Deadeye5589/RedButton/V2/Schematic/Schematic.pdf

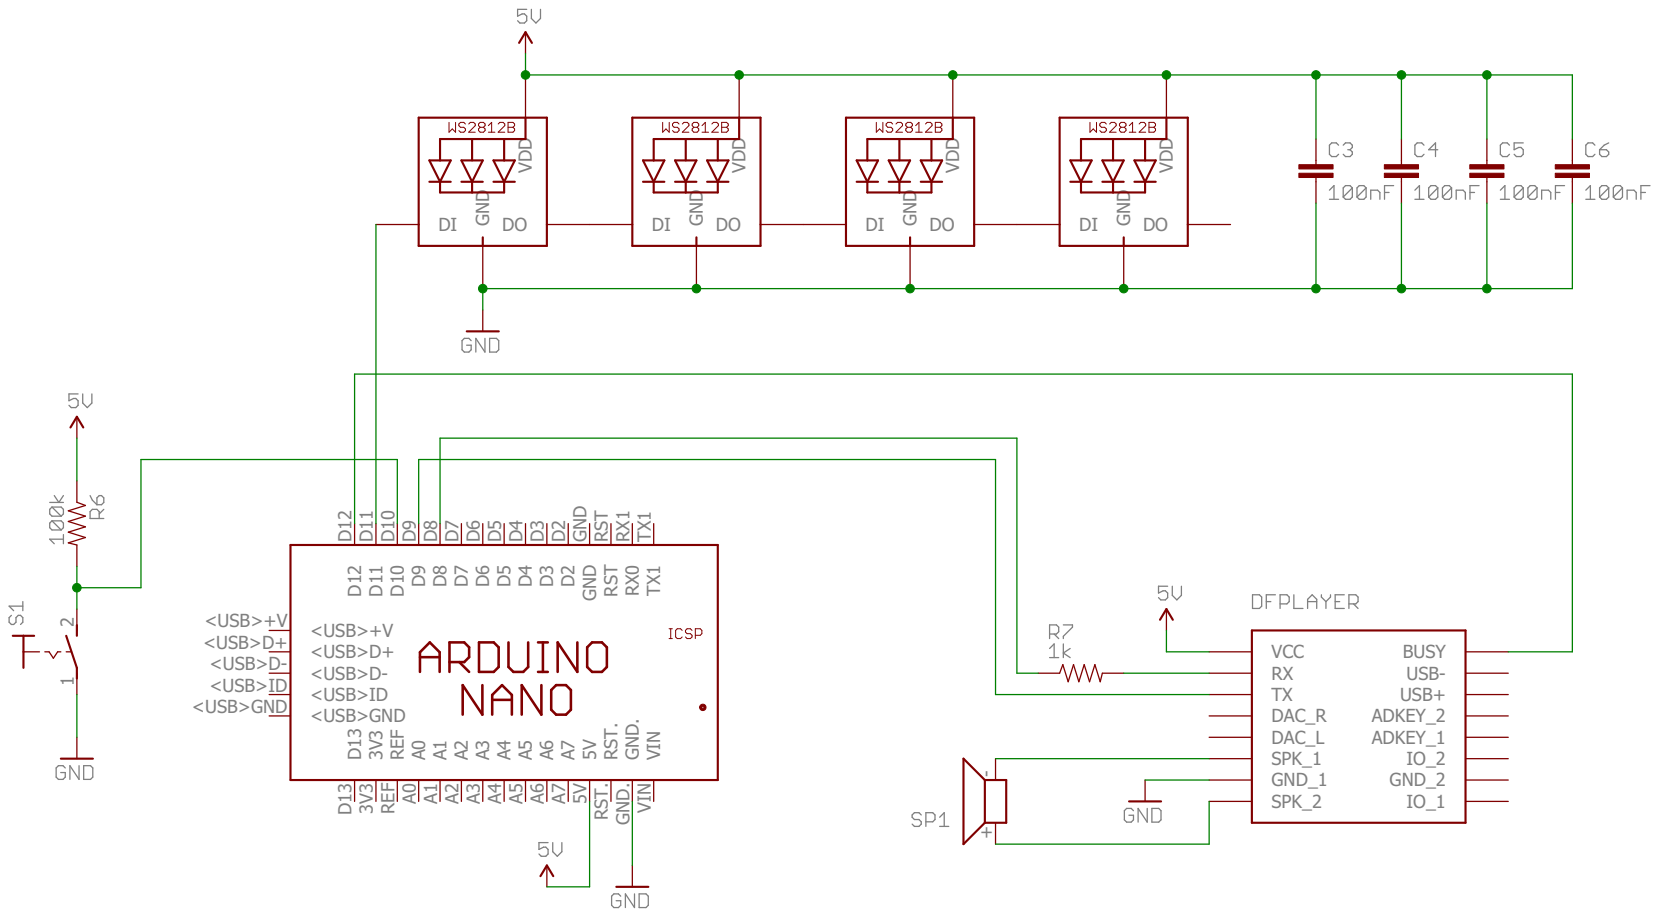
[picture p1: page 1]

<USB>ID
<USB>GND
