Deadeye5589/RedButton/V1/Schematic/Schematic.pdf

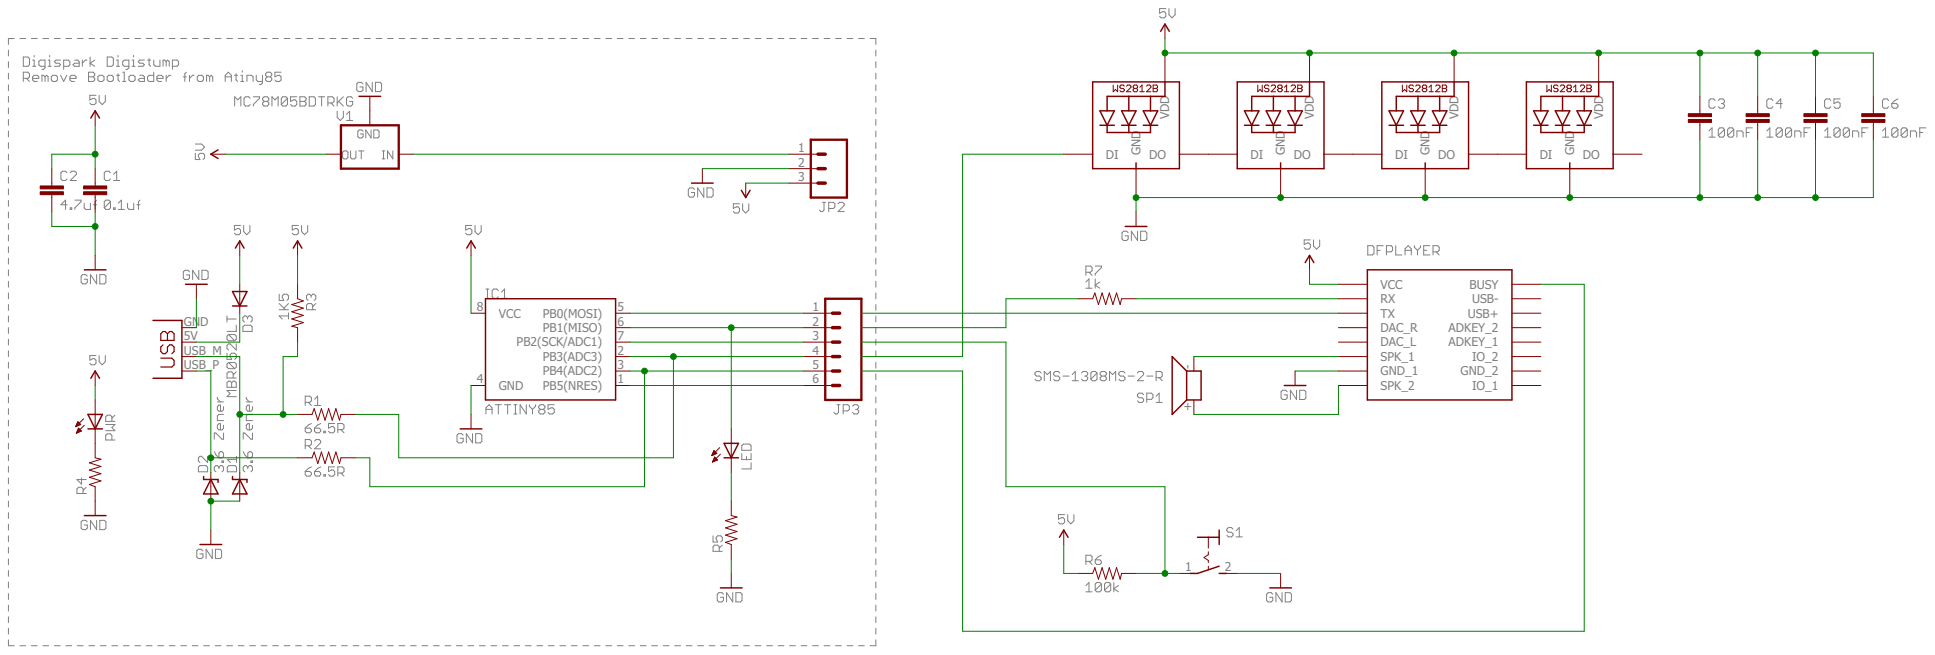
[picture p2: page 1]
