Deadeye5589/RedButton/V2/Schematic/Schematic.sch

## EAGLE design V2/Schematic/Schematic.sch (2019-01-21)

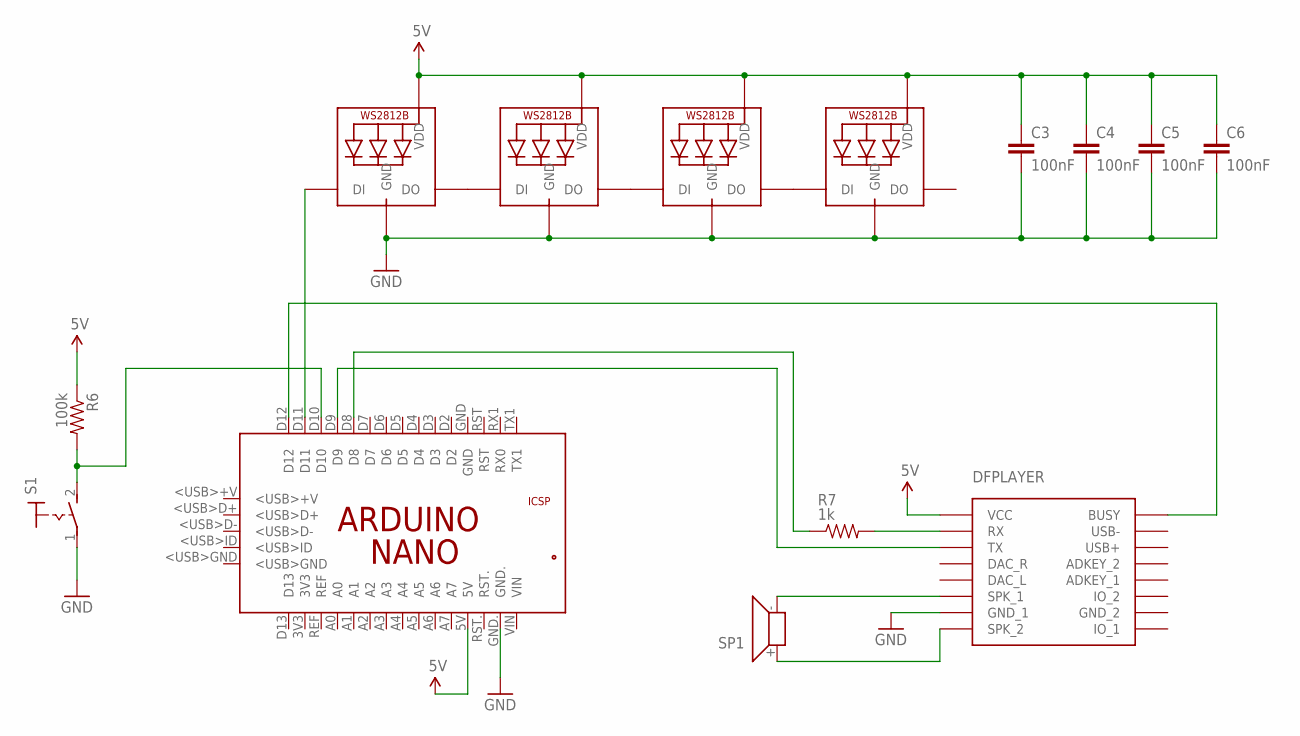
[picture p3: schematic Schematic.sch]

Parts:
C3, C4, C5, C6: 100nF; C102-054X133
LED1, LED2, LED3, LED4: WS2812B3535; LED3535
PCB1: ARDUINO_NANO
R6: 100k; 0402-RES
R7: 1k; 0402-RES
S1: MS243
SP1: SMS-1308MS-2-R
U$8: DF; DFPLAYER

Connections:
5V: C3.1, C4.1, C5.1, C6.1, LED1.2 (VDD), LED2.2 (VDD), LED3.2 (VDD), LED4.2 (VDD), PCB1.5V, R6.1, U$8.VCC
GND: C3.2, C4.2, C5.2, C6.2, LED1.4 (GND), LED2.4 (GND), LED3.4 (GND), LED4.4 (GND), PCB1.GND., S1.1, U$8.GND_1
unnamed: PCB1.D12, U$8.BUSY
unnamed: PCB1.D10, R6.2, S1.2 (S)
unnamed: PCB1.D9, U$8.TX
unnamed: SP1.- (2), U$8.SPK1 (SPK_1)
unnamed: SP1.+ (1), U$8.SPK2 (SPK_2)
unnamed: LED1.3 (DO), LED2.1 (DI)
unnamed: R7.2, U$8.RX
unnamed: LED1.1 (DI), PCB1.D11
unnamed: LED2.3 (DO), LED3.1 (DI)
unnamed: LED3.3 (DO), LED4.1 (DI)
unnamed: PCB1.D8, R7.1

Notes on the sheet:
DFPLAYER
