Deadeye5589/RedButton/(commit log)

2018-11-23 Add files via upload
    V1 of the RedButton Software
    Short push play random song in current folder
    Long push play first song in root folder
    Double click cycle through folders
    [RedButton.ino]
2018-11-24 Eagle7 Schematic for RedButton
    Parts used:
    Digispark Digistump (Atiny85 with bootloader removed)
    DFPLAYER
    WS2812B LEDs
    [Schematic.sch]
2018-11-26 Precompiled Hex File for Red Button
2018-11-26 Not needed since Arduino exclusive file
2018-11-27 Reworked Code with reduced overhead
    Number of files will be loaded at startup and not at each folder change anymore.
    Also created a Version for Uno Boards with additional debug output on the serial monitor.
    [RedButton_Uno_Debug.ino]
2018-11-27 Colors of double button press corrected
2018-12-03 How to use the Hot Button
2018-12-14 V1.1
    Found out that some dfplayer modules need longer times before their UART is responding.
    Instead of trying once to initialize the dfplayer now a loop is trying every 100µs till success.
2019-01-10 Added series resistor in RX line to minimize noise
    [Schematic.sch]
2019-01-21 Removed for new project structur
    [Schematic.sch]
2019-01-21 V1 release
    All information for the old V1 of the Red Button project.
    Stored for legacy purpose.
    Not recommended for new project.
    [Schematic.sch]
2019-01-21 Release V2.0
    For Nano boards
    Gives us wear leveling EEPROM storage to remember the last played song and folder when powering down the Red Button.
    Due to the wear leveling the EEPROM will reach it's life time after ~4 Million played songs per folder.
    So you might need to change the tact switch before the EEPROM.
    [Schematic.sch]
